INHA-NARAE/STM32-FC/(threads)

Thread 2 (2025-06-19):

LPS22HH 동작 안함.

leecurrent04, 2025-06-19:
[[Taiga] LPS22HH 기압계 동작 안함](https://taiga.naraeinha.cc/project/hanggongjeonja/issue/134)

LPS22HH 기압계 Software 리셋 안됨.
---------------------------

SW 리셋이 동작하지 않아, 센서 값도 0으로 출력되는 듯.

[코드](https://github.com/INHA-NARAE/STM32-FC/blob/main/SW/Plane/Core/Src/FC_AHRS/FC_Baro/LPS22HH/LPS22HH.c#L45)

```c
// STM32-FC/SW/Plane/Core/Src/FC_AHRS/FC_Baro/LPS22HH/LPS22HH.c

// Software Reset LPS22HH
temp_reg = LPS22HH_Readbyte(CTRL_REG2);
temp_reg = temp_reg | 0x04;
LPS22HH_Writebyte(CTRL_REG2, temp_reg);
while((LPS22HH_Readbyte(CTRL_REG2)&0x04)!=0x00){
}
```

데이터시트에 따르면,  SW 리셋 비트를 1로 설정하면 리셋 동작이 수행되고 비트가 0으로 되어야 한다.
그러나 비트가 0으로 안 변함.

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

### 로직 분석

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

첫번째 초록색 : 0x91 CTRL\_REG2 값 요청, 0x10 응답
첫번째 파란색 : 0x11 0x14 CTRL\_REG2에 0x14 쓰기 (SW 리셋 명령)
두번째 초록색 : 0x91 CTRL\_REG2 값 요청, 0x14 응답 (SW 리셋 중)
이하 반복

### 예상 원인

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

전원부 커패시터 이상으로 추정.
VDD 및 VDDIO에 각각 100nF 커패시터 연결 권장.
VDD에 4.7uF 커패시터 추가 권장.
그러나 실제 구현된 회로에서는 4.7uF만 연결됨.

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

커패시터 교체 후 동일 증상 시, 전류 부족일 수도 있음.
AHRS 용 별도 3.3V 레귤레이터 도입

Thread 4 (2025-06-23):

BMI323 에러

leecurrent04, 2025-06-23:
# 증상

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

BMI323 센서 값이 -1.0, 1.0으로 출력 됨.

초기 연결 이후, 일정 시간 경과시 문제 발생하는 것으로 추정됨.

# 특이점

로직 아날라이저 연결 후 부팅시, **증상 재현 안됨**.
증상 발현 후 로직 아날라이저 연결 시 MOSI 신호 에러

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

leecurrent04, 2025-07-25:
같은 SPI3 라인에 있는 LIS2MDF 센서의 기본 동작이 3-wire SPI 그랬던 것으로 추정됨.
해당 센서의 동작 모드를 4-wire SPI 설정하니 문제가 발생하지 않음.

Closed 2025-07-25.

Thread 19 (2025-09-05):

bug: roll, pitch에 따른 yaw 변동

sungho2574, 2025-09-05:
yaw는 그대로 둔 상테에서 roll, pitch에만 변화를 줘도 yaw가 같이 변합니다.
yaw축 pid 튜닝을 하기 전에 이 부분이 먼저 해결되어야 할 것 같습니다.

- 아래는 pitch에만 변화를 줄 때의 그래프입니다.
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

- 아래는 roll에만 변화를 줄 때의 그래프입니다.
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

그래프 캡쳐를 좀 잘못했는데 빨간색이 roll, 초록색이 pitch, 파란색이 yaw입니다.

leecurrent04, 2025-09-09:
지금 YAW 계산을 지자계와 roll+pitch로 계산하고 있는데,
지자계 값도 보정이 잘 안되어 있어요.

https://discord.com/channels/1289170468883927081/1289172196484186133/1413210099148914728
