INHA-NARAE/STM32-FC/HW/STM32-FC/STM32-FC.kicad_pcb

## KiCad design HW/STM32-FC/STM32-FC.kicad_pcb (2025-06-19)

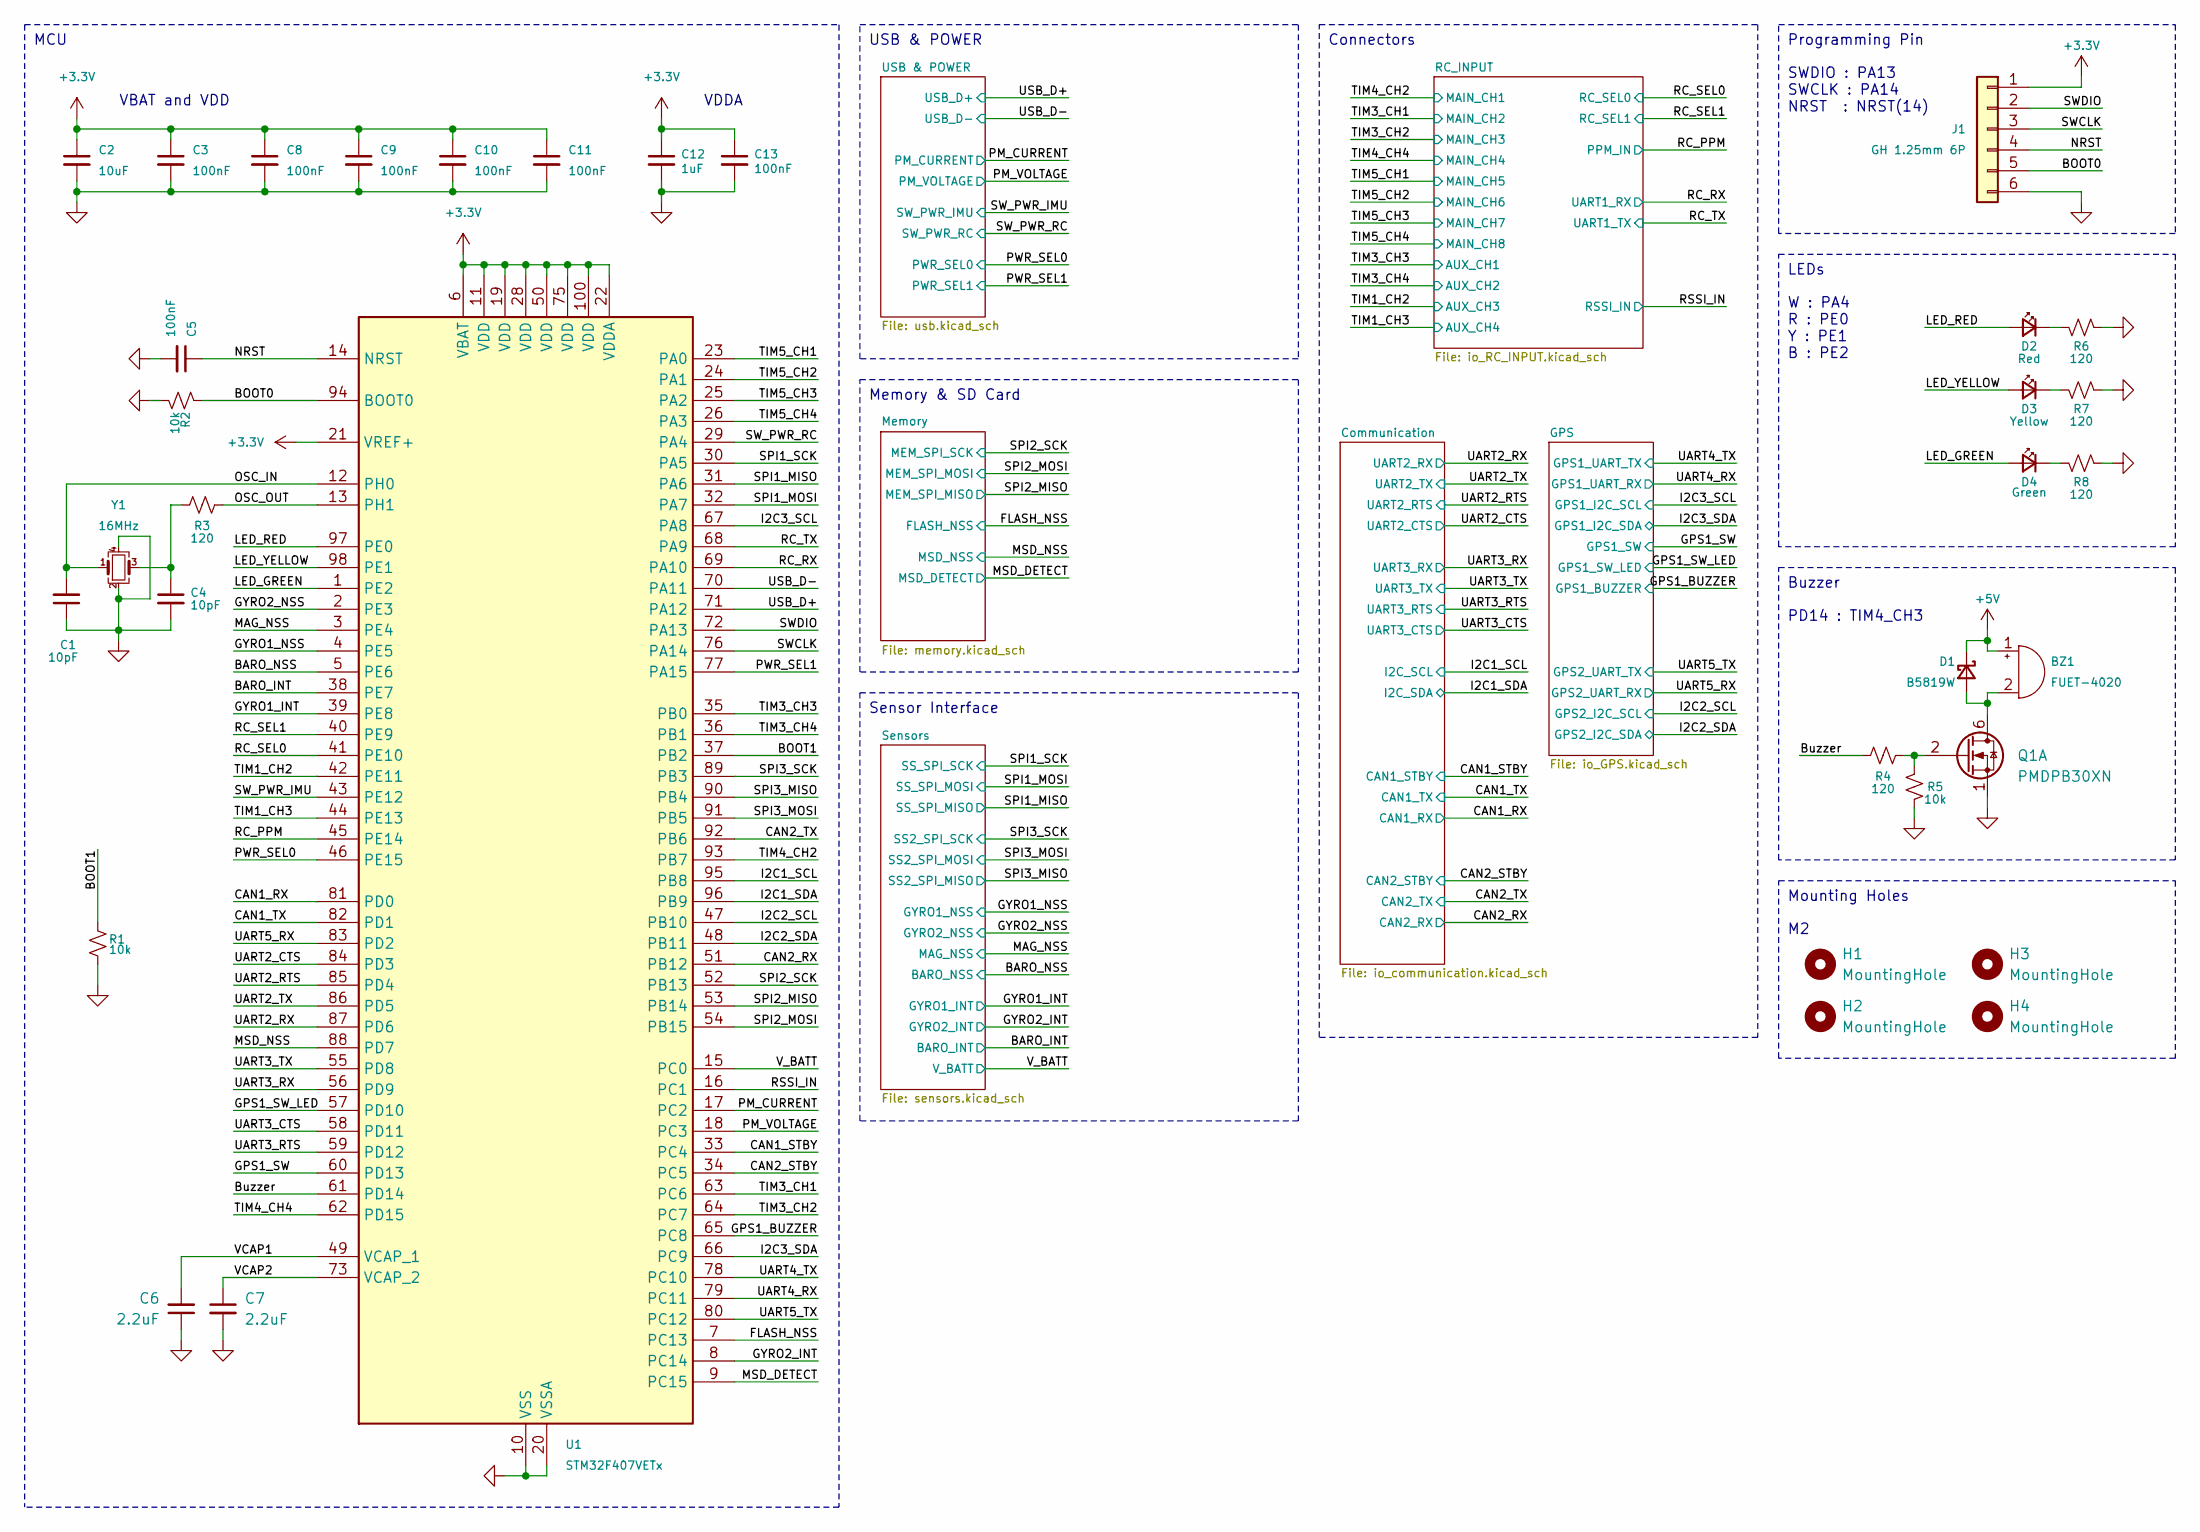
[picture p1: schematic STM32-FC.kicad_sch, STM32 Flight Controller]

Parts:
BZ1: FUET-4020; LCSC C391027
C1, C4: 10pF; C_0402_1005Metric; LCSC C1545
C2: 10uF; C_0402_1005Metric; LCSC C307415
C3, C5, C8, C9, C10, C11, C13: 100nF; C_0402_1005Metric; LCSC C1525
C6, C7: 2.2uF; C_0402_1005Metric; LCSC C170151
C12: 1uF; C_0402_1005Metric; LCSC C14445
D1: B5819W; D_SOD-323; LCSC C22624
D2: Red; LED_0402_1005Metric; LCSC C130719
D3: Yellow; LED_0402_1005Metric; LCSC C130721
D4: Green; LED_0402_1005Metric; LCSC C130722
H1, H2, H3, H4: MountingHole; MountingHole_2.2mm_M2
J1: GH 1.25mm 6P; JST_GH_SM06B-GHS-TB_06x1.25mm_Angled; LCSC C133065
Q1: PMDPB30XN; Nexperia_SOT1118; LCSC C478009
R1, R2, R5: 10k; R_0402_1005Metric; LCSC C25531
R3, R4, R6, R7, R8: 120; R_0402_1005Metric; LCSC C25079
U1: STM32F407VETx; LQFP-100_14x14mm_P0.5mm; LCSC C28730
Y1: 16MHz; Crystal_SMD_Abracon_ABM8G-4Pin_3.2x2.5mm; LCSC C1985423

Connections:
+3.3V: C2.1, C3.1, C8.1, C9.1, C10.1, C11.1, C12.1, C13.1, J1.1, U1.6 (VBAT), U1.11 (VDD), U1.19 (VDD), U1.21 (VREF+), U1.22 (VDDA), U1.28 (VDD), U1.50 (VDD), U1.75 (VDD), U1.100 (VDD); also elsewhere on the board
+5V: BZ1.1 (-), D1.1 (K); also elsewhere on the board
/BARO_INT: U1.38 (PE7); also elsewhere on the board
/BARO_NSS: U1.5 (PE6); also elsewhere on the board
/BOOT0: J1.5, R2.1, U1.94 (BOOT0)
/BOOT1: R1.1, U1.37 (PB2)
/Buzzer: R4.1, U1.61 (PD14)
/CAN1_RX: U1.81 (PD0); also elsewhere on the board
/CAN1_STBY: U1.33 (PC4); also elsewhere on the board
/CAN1_TX: U1.82 (PD1); also elsewhere on the board
/CAN2_RX: U1.51 (PB12); also elsewhere on the board
/CAN2_STBY: U1.34 (PC5); also elsewhere on the board
/CAN2_TX: U1.92 (PB6); also elsewhere on the board
/FLASH_NSS: U1.7 (PC13); also elsewhere on the board
/GPS1_BUZZER: U1.65 (PC8); also elsewhere on the board
/GPS1_SW: U1.60 (PD13); also elsewhere on the board
/GPS1_SW_LED: U1.57 (PD10); also elsewhere on the board
/GYRO1_INT: U1.39 (PE8); also elsewhere on the board
/GYRO1_NSS: U1.4 (PE5); also elsewhere on the board
/GYRO2_INT: U1.8 (PC14); also elsewhere on the board
/GYRO2_NSS: U1.2 (PE3); also elsewhere on the board
/I2C1_SCL: U1.95 (PB8); also elsewhere on the board
/I2C1_SDA: U1.96 (PB9); also elsewhere on the board
/I2C2_SCL: U1.47 (PB10); also elsewhere on the board
/I2C2_SDA: U1.48 (PB11); also elsewhere on the board
/I2C3_SCL: U1.67 (PA8); also elsewhere on the board
/I2C3_SDA: U1.66 (PC9); also elsewhere on the board
/LED_GREEN: D4.2 (A), U1.1 (PE2)
/LED_RED: D2.2 (A), U1.97 (PE0)
/LED_YELLOW: D3.2 (A), U1.98 (PE1)
/MAG_NSS: U1.3 (PE4); also elsewhere on the board
/MSD_DETECT: U1.9 (PC15); also elsewhere on the board
/MSD_NSS: U1.88 (PD7); also elsewhere on the board
/NRST: C5.1, J1.4, U1.14 (NRST)
/OSC_IN: C1.2, U1.12 (PH0), Y1.1
/OSC_OUT: R3.2, U1.13 (PH1)
/PM_CURRENT: U1.17 (PC2); also elsewhere on the board
/PM_VOLTAGE: U1.18 (PC3); also elsewhere on the board
/PWR_SEL0: U1.46 (PE15); also elsewhere on the board
/PWR_SEL1: U1.77 (PA15); also elsewhere on the board
/RC_PPM: U1.45 (PE14); also elsewhere on the board
/RC_RX: U1.69 (PA10); also elsewhere on the board
/RC_SEL0: U1.41 (PE10); also elsewhere on the board
/RC_SEL1: U1.40 (PE9); also elsewhere on the board
/RC_TX: U1.68 (PA9); also elsewhere on the board
/RSSI_IN: U1.16 (PC1); also elsewhere on the board
/SPI1_MISO: U1.31 (PA6); also elsewhere on the board
/SPI1_MOSI: U1.32 (PA7); also elsewhere on the board
/SPI1_SCK: U1.30 (PA5); also elsewhere on the board
/SPI2_MISO: U1.53 (PB14); also elsewhere on the board
/SPI2_MOSI: U1.54 (PB15); also elsewhere on the board
/SPI2_SCK: U1.52 (PB13); also elsewhere on the board
/SPI3_MISO: U1.90 (PB4); also elsewhere on the board
/SPI3_MOSI: U1.91 (PB5); also elsewhere on the board
/SPI3_SCK: U1.89 (PB3); also elsewhere on the board
/SWCLK: J1.3, U1.76 (PA14)
/SWDIO: J1.2, U1.72 (PA13)
/SW_PWR_IMU: U1.43 (PE12); also elsewhere on the board
/SW_PWR_RC: U1.29 (PA4); also elsewhere on the board
/TIM1_CH2: U1.42 (PE11); also elsewhere on the board
/TIM1_CH3: U1.44 (PE13); also elsewhere on the board
/TIM3_CH1: U1.63 (PC6); also elsewhere on the board
/TIM3_CH2: U1.64 (PC7); also elsewhere on the board
/TIM3_CH3: U1.35 (PB0); also elsewhere on the board
/TIM3_CH4: U1.36 (PB1); also elsewhere on the board
/TIM4_CH2: U1.93 (PB7); also elsewhere on the board
/TIM4_CH4: U1.62 (PD15); also elsewhere on the board
/TIM5_CH1: U1.23 (PA0); also elsewhere on the board
/TIM5_CH2: U1.24 (PA1); also elsewhere on the board
/TIM5_CH3: U1.25 (PA2); also elsewhere on the board
/TIM5_CH4: U1.26 (PA3); also elsewhere on the board
/UART2_CTS: U1.84 (PD3); also elsewhere on the board
/UART2_RTS: U1.85 (PD4); also elsewhere on the board
/UART2_RX: U1.87 (PD6); also elsewhere on the board
/UART2_TX: U1.86 (PD5); also elsewhere on the board
/UART3_CTS: U1.58 (PD11); also elsewhere on the board
/UART3_RTS: U1.59 (PD12); also elsewhere on the board
/UART3_RX: U1.56 (PD9); also elsewhere on the board
/UART3_TX: U1.55 (PD8); also elsewhere on the board
/UART4_RX: U1.79 (PC11); also elsewhere on the board
/UART4_TX: U1.78 (PC10); also elsewhere on the board
/UART5_RX: U1.83 (PD2); also elsewhere on the board
/UART5_TX: U1.80 (PC12); also elsewhere on the board
/USB_D+: U1.71 (PA12); also elsewhere on the board
/USB_D-: U1.70 (PA11); also elsewhere on the board
/VCAP1: C6.2, U1.49 (VCAP_1)
/VCAP2: C7.1, U1.73 (VCAP_2)
/V_BATT: U1.15 (PC0); also elsewhere on the board
unnamed: BZ1.2 (+), D1.2 (A), Q1.6 (D), Q1.7 (D)
unnamed: C4.1, R3.1, Y1.3
unnamed: D2.1 (K), R6.1
unnamed: D3.1 (K), R7.1
unnamed: D4.1 (K), R8.1
unnamed: Q1.2 (G), R4.2, R5.1

Notes on the sheet:
Connectors
PD14 : TIM4_CH3
MCU
VDDA
Buzzer
Sensor Interface
LEDs
Programming Pin
Memory & SD Card
USB & POWER
W : PA4 R : PE0 Y : PE1 B : PE2
SWDIO : PA13 SWCLK : PA14 NRST : NRST(14)
VBAT and VDD
Mounting Holes

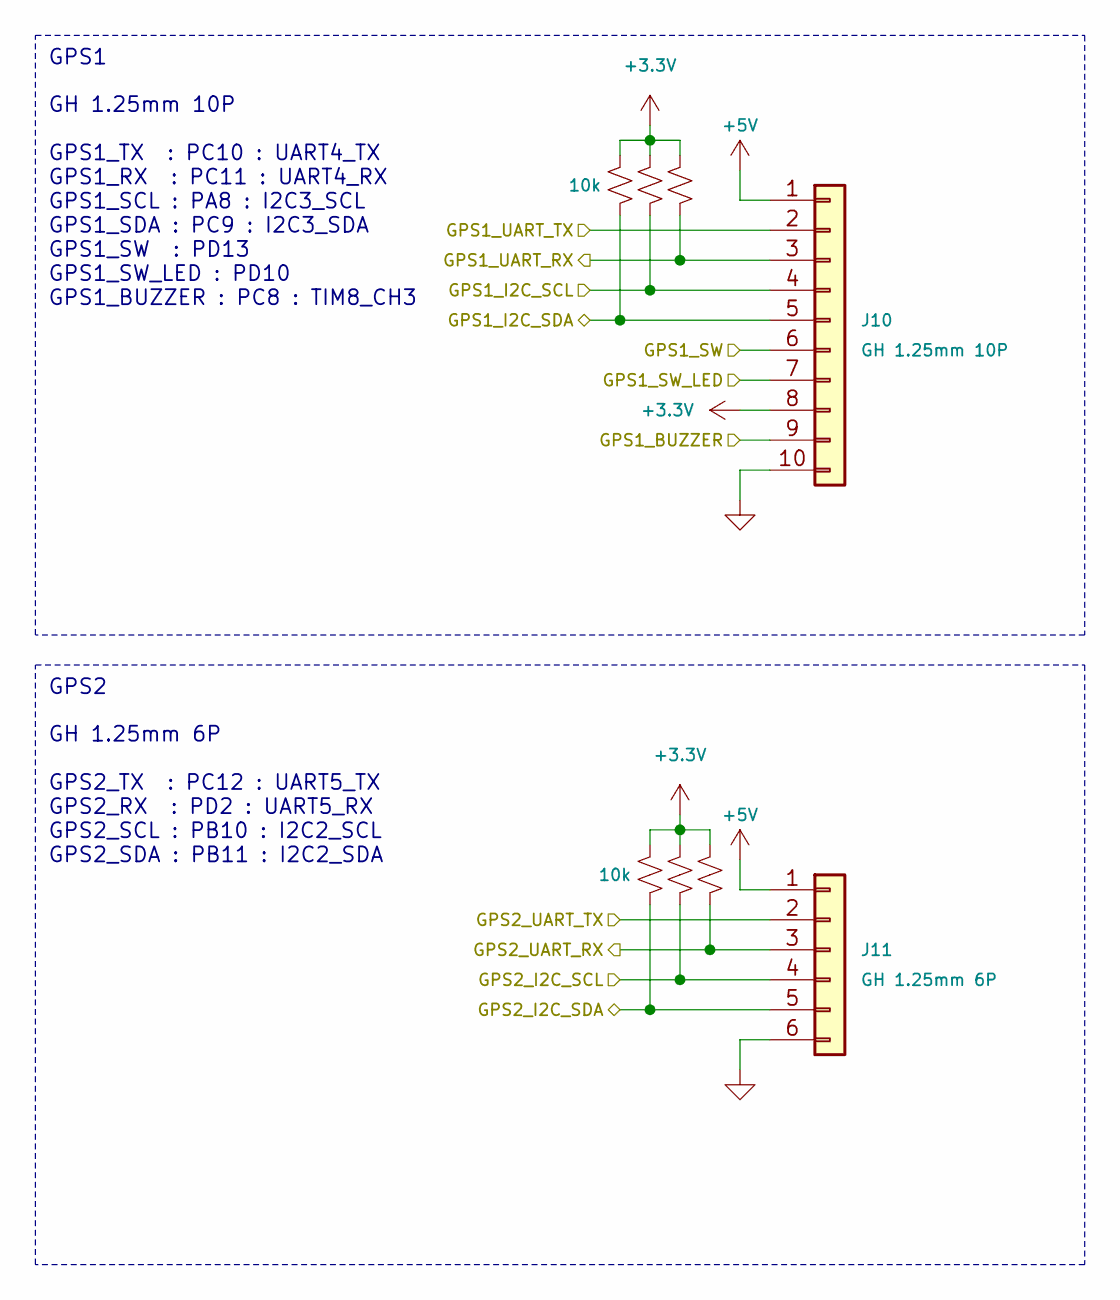
[picture p2: schematic io_GPS.kicad_sch, GPS]

Parts:
J10: GH 1.25mm 10P; JST_GH_SM10B-GHS-TB_10x1.25mm_Angled; LCSC C2683602
J11: GH 1.25mm 6P; JST_GH_SM06B-GHS-TB_06x1.25mm_Angled; LCSC C133065
R38, R39, R40, R41, R42, R43: 10k; R_0402_1005Metric; LCSC C25531

Connections:
+3.3V: J10.8, R38.1, R39.1, R40.1, R41.1, R42.1, R43.1; also elsewhere on the board
+5V: J10.1, J11.1; also elsewhere on the board
/GPS1_BUZZER: J10.9; also elsewhere on the board
/GPS1_SW: J10.6; also elsewhere on the board
/GPS1_SW_LED: J10.7; also elsewhere on the board
/I2C2_SCL: J11.4, R42.2; also elsewhere on the board
/I2C2_SDA: J11.5, R40.2; also elsewhere on the board
/I2C3_SCL: J10.4, R39.2; also elsewhere on the board
/I2C3_SDA: J10.5, R38.2; also elsewhere on the board
/UART4_RX: J10.3, R41.2; also elsewhere on the board
/UART4_TX: J10.2; also elsewhere on the board
/UART5_RX: J11.3, R43.2; also elsewhere on the board
/UART5_TX: J11.2; also elsewhere on the board

Notes on the sheet:
GH 1.25mm 10P GPS1_TX : PC10 : UART4_TX GPS1_RX : PC11 : UART4_RX GPS1_SCL : PA8 : I2C3_SCL GPS1_SDA : PC9 : I2C3_SDA GPS1_SW : PD13 GPS1_SW_LED : PD10 GPS1_BUZZER : PC8 : TIM8_CH3
GH 1.25mm 6P GPS2_TX : PC12 : UART5_TX GPS2_RX : PD2 : UART5_RX GPS2_SCL : PB10 : I2C2_SCL GPS2_SDA : PB11 : I2C2_SDA
GPS2
GPS1

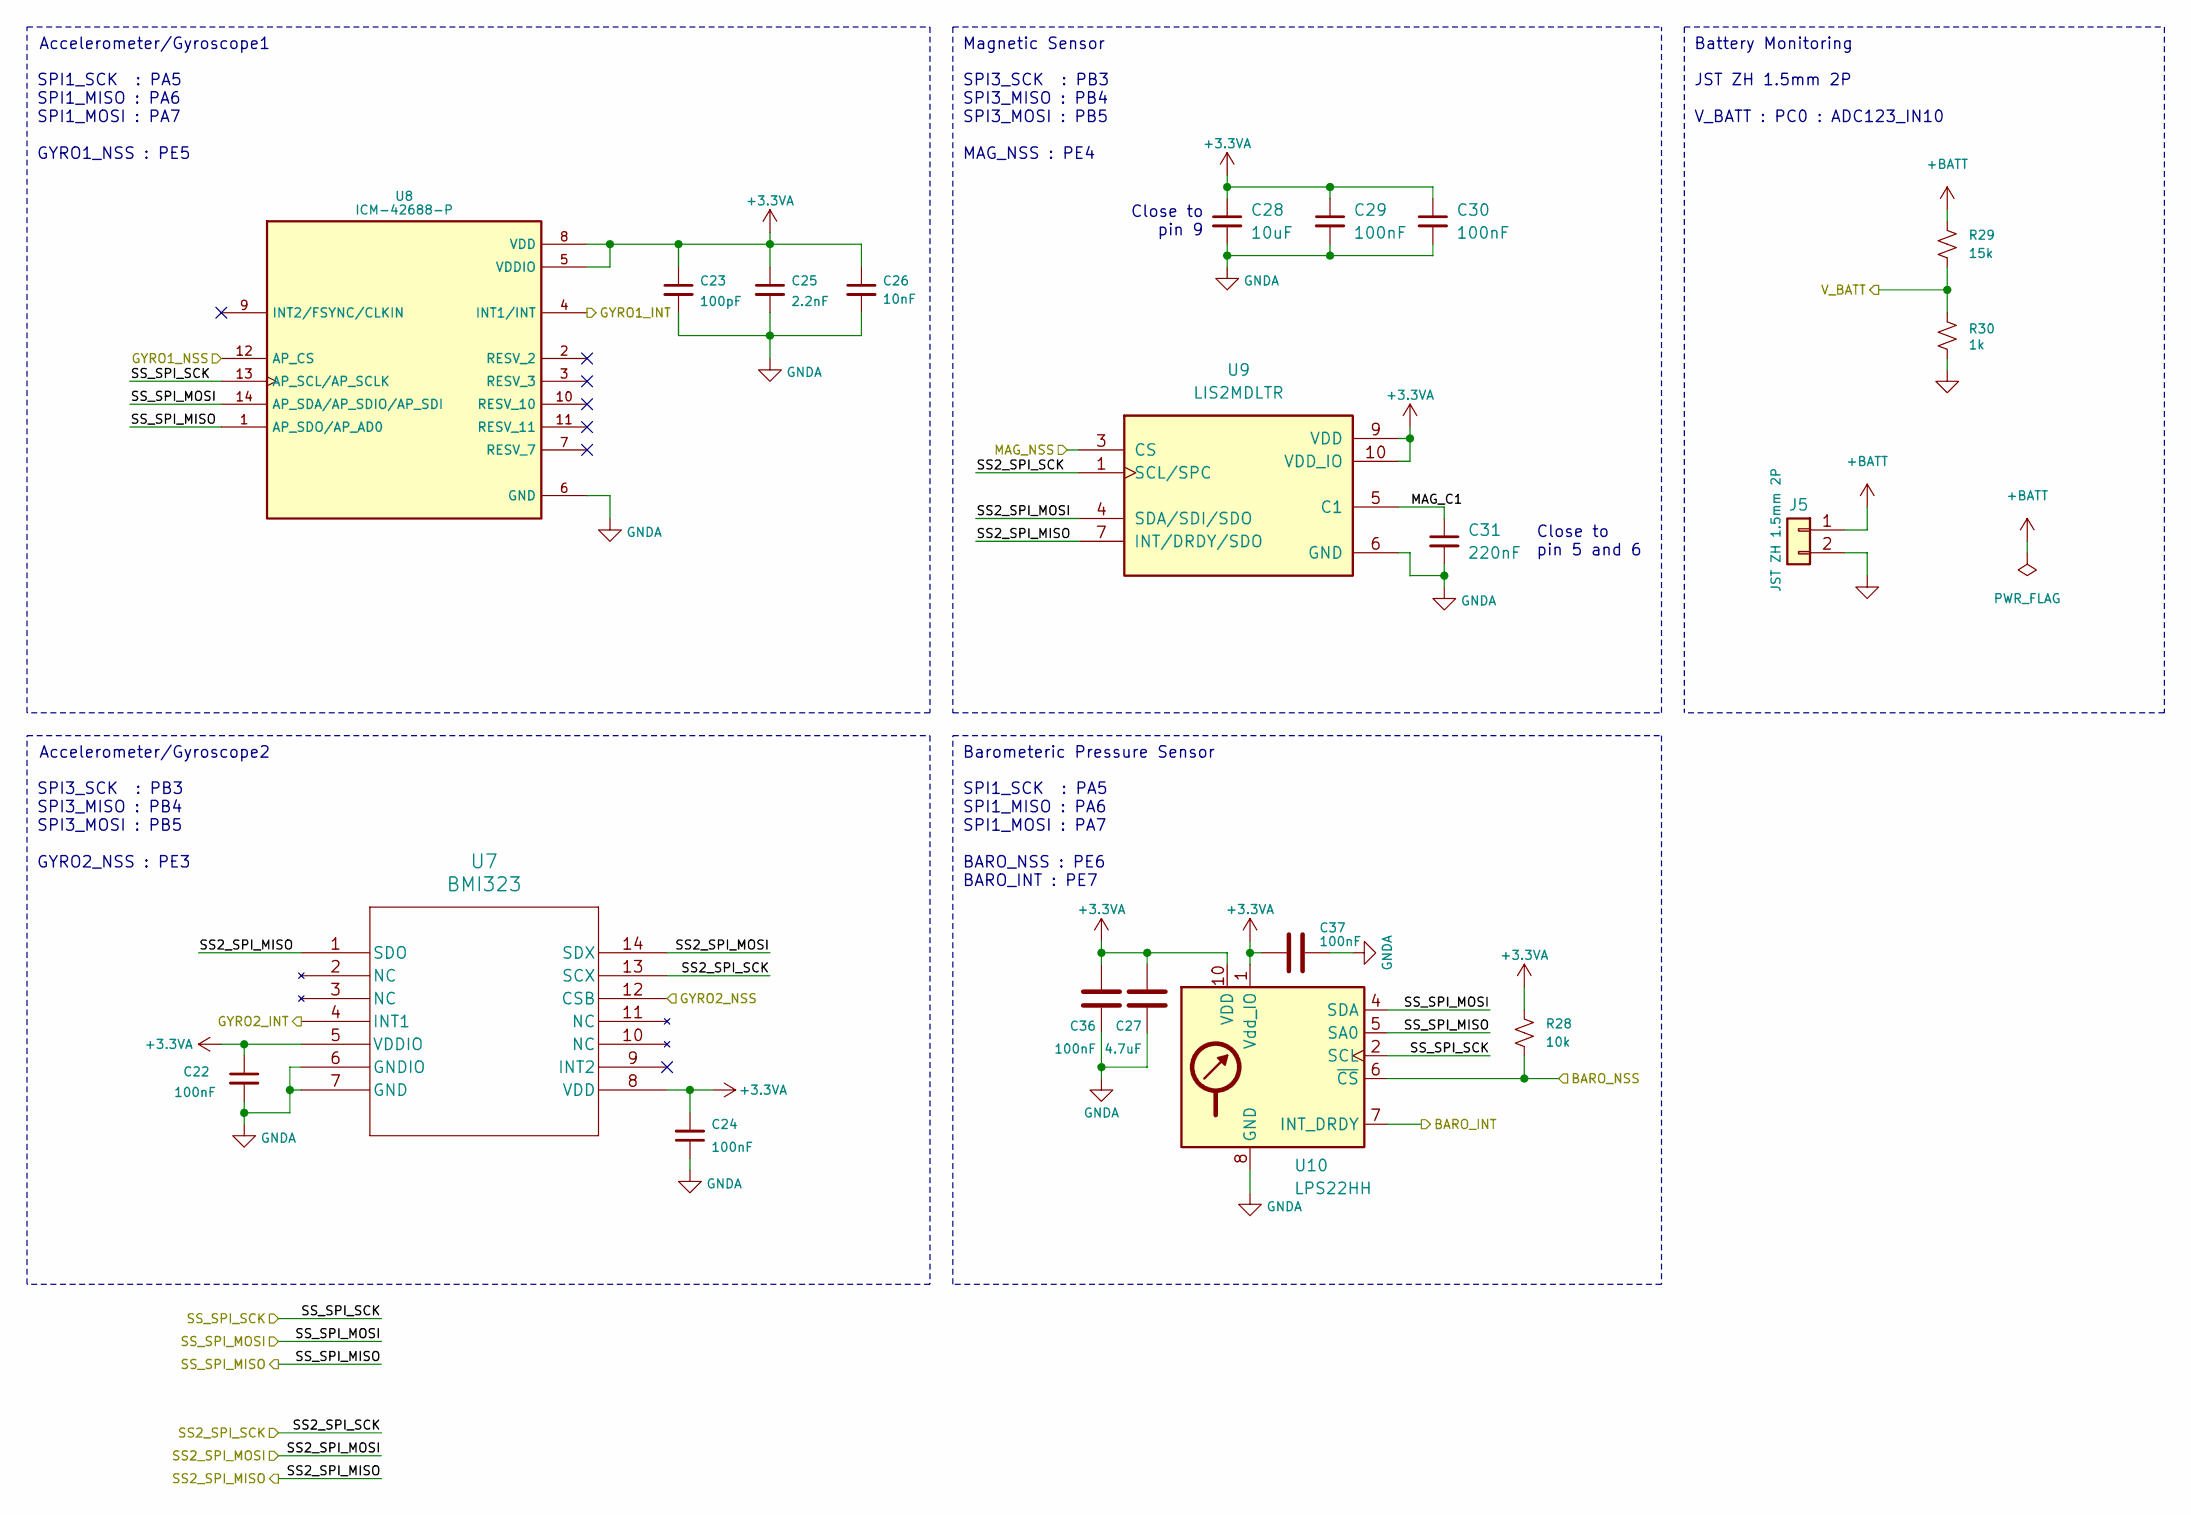
[picture p3: schematic sensors.kicad_sch]

Parts:
C22, C24, C29, C30: 100nF; C_0402_1005Metric; LCSC C1525
C23: 100pF; C_0402_1005Metric; LCSC C152819
C25: 2.2nF; C_0402_1005Metric; LCSC C84703
C26: 10nF; C_0402_1005Metric; LCSC C15195
C27: 4.7uF; C_0402_1005Metric; LCSC C307423
C28: 10uF; C_0402_1005Metric; LCSC C307415
C31: 220nF; C_0402_1005Metric; LCSC C16651
C36, C37: 100nF; C_0402_1005Metric; LCSC C307423
J5: JST ZH 1.5mm 2P; JST_ZH_S2B-ZR-SM4A-TF_1x02-1MP_P1.50mm_Horizontal; LCSC C265329
R28: 10k; R_0402_1005Metric; LCSC C25531
R29: 15k; R_0402_1005Metric; LCSC C25539
R30: 1k; R_0402_1005Metric; LCSC C106235
U7: BMI323; BMI323_L; LCSC C5368700
U8: ICM-42688-P; IIM42352_L; LCSC C1850418
U9: LIS2MDLTR; PARTREV Rev 5; LCSC C919695
U10: LPS22HH; ST_HLGA-10_2x2mm_P0.5mm_LayoutBorder3x2y; LCSC C2827824

Connections:
+3.3VA: C22.1, C23.1, C24.2, C25.1, C26.1, C27.2, C28.1, C29.1, C30.1, C36.2, C37.2, R28.1, U7.5 (VDDIO), U7.8 (VDD), U8.5 (VDDIO), U8.8 (VDD), U9.9 (VDD), U9.10 (VDD_IO), U10.1 (Vdd_IO), U10.10 (VDD); also elsewhere on the board
+BATT: J5.1, R29.1
/BARO_INT: U10.7 (INT_DRDY); also elsewhere on the board
/BARO_NSS: R28.2, U10.6 (~CS); also elsewhere on the board
/GYRO1_INT: U8.4 (INT1/INT); also elsewhere on the board
/GYRO1_NSS: U8.12 (AP_CS); also elsewhere on the board
/GYRO2_INT: U7.4 (INT1); also elsewhere on the board
/GYRO2_NSS: U7.12 (CSB); also elsewhere on the board
/MAG_NSS: U9.3 (CS); also elsewhere on the board
/SPI1_MISO: U8.1 (AP_SDO/AP_AD0), U10.5 (SA0); also elsewhere on the board
/SPI1_MOSI: U8.14 (AP_SDA/AP_SDIO/AP_SDI), U10.4 (SDA); also elsewhere on the board
/SPI1_SCK: U8.13 (AP_SCL/AP_SCLK), U10.2 (SCL); also elsewhere on the board
/SPI3_MISO: U7.1 (SDO), U9.7 (INT/DRDY/SDO); also elsewhere on the board
/SPI3_MOSI: U7.14 (SDX), U9.4 (SDA/SDI/SDO); also elsewhere on the board
/SPI3_SCK: U7.13 (SCX), U9.1 (SCL/SPC); also elsewhere on the board
/Sensors/MAG_C1: C31.1, U9.5 (C1)
/V_BATT: R29.2, R30.1; also elsewhere on the board

Notes on the sheet:
Close to pin 9
Magnetic Sensor
Barometeric Pressure Sensor
Battery Monitoring
Accelerometer/Gyroscope1
SPI3_SCK : PB3 SPI3_MISO : PB4 SPI3_MOSI : PB5 GYRO2_NSS : PE3
SPI1_SCK : PA5 SPI1_MISO : PA6 SPI1_MOSI : PA7 BARO_NSS : PE6 BARO_INT : PE7
JST ZH 1.5mm 2P V_BATT : PC0 : ADC123_IN10
SPI1_SCK : PA5 SPI1_MISO : PA6 SPI1_MOSI : PA7 GYRO1_NSS : PE5
Accelerometer/Gyroscope2
Close to pin 5 and 6
SPI3_SCK : PB3 SPI3_MISO : PB4 SPI3_MOSI : PB5 MAG_NSS : PE4

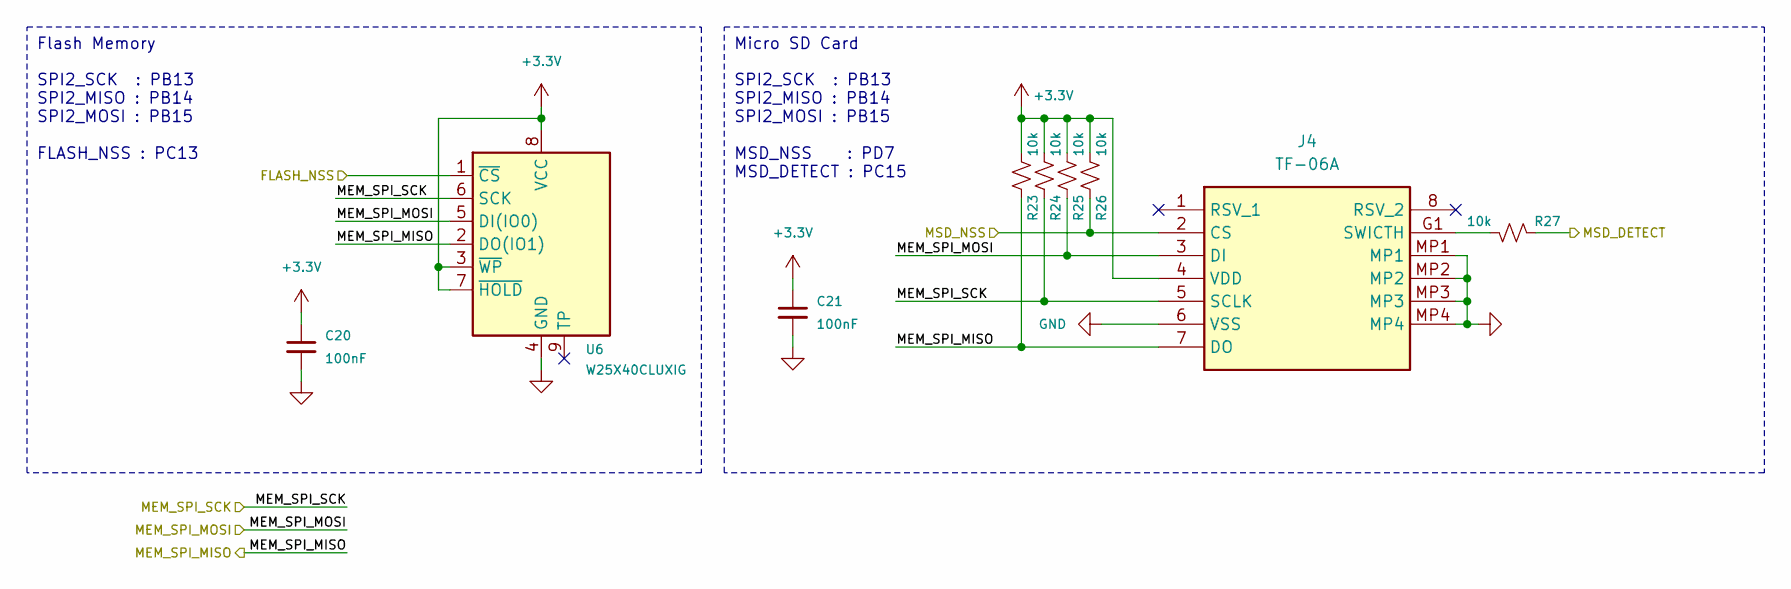
[picture p4: schematic memory.kicad_sch]

Parts:
C20, C21: 100nF; C_0402_1005Metric; LCSC C1525
J4: TF-06A; TF06A; Manufacturer_Part_Number TF-06A; LCSC C693844
R23, R24, R25, R26, R27: 10k; R_0402_1005Metric; LCSC C25531
U6: W25X40CLUXIG; USON_LUXIG TR_WIN-L; LCSC C401661

Connections:
+3.3V: C20.1, C21.1, J4.4 (VDD), R23.1, R24.1, R25.1, R26.1, U6.3 (~WP), U6.7 (~HOLD), U6.8 (VCC); also elsewhere on the board
/FLASH_NSS: U6.1 (~CS); also elsewhere on the board
/MSD_DETECT: R27.1; also elsewhere on the board
/MSD_NSS: J4.2 (CS), R26.2; also elsewhere on the board
/SPI2_MISO: J4.7 (DO), R23.2, U6.2 (DO(IO1)); also elsewhere on the board
/SPI2_MOSI: J4.3 (DI), R25.2, U6.5 (DI(IO0)); also elsewhere on the board
/SPI2_SCK: J4.5 (SCLK), R24.2, U6.6 (SCK); also elsewhere on the board
unnamed: J4.G1 (SWICTH), R27.2

Notes on the sheet:
Micro SD Card
SPI2_SCK : PB13 SPI2_MISO : PB14 SPI2_MOSI : PB15 FLASH_NSS : PC13
Flash Memory
SPI2_SCK : PB13 SPI2_MISO : PB14 SPI2_MOSI : PB15 MSD_NSS : PD7 MSD_DETECT : PC15

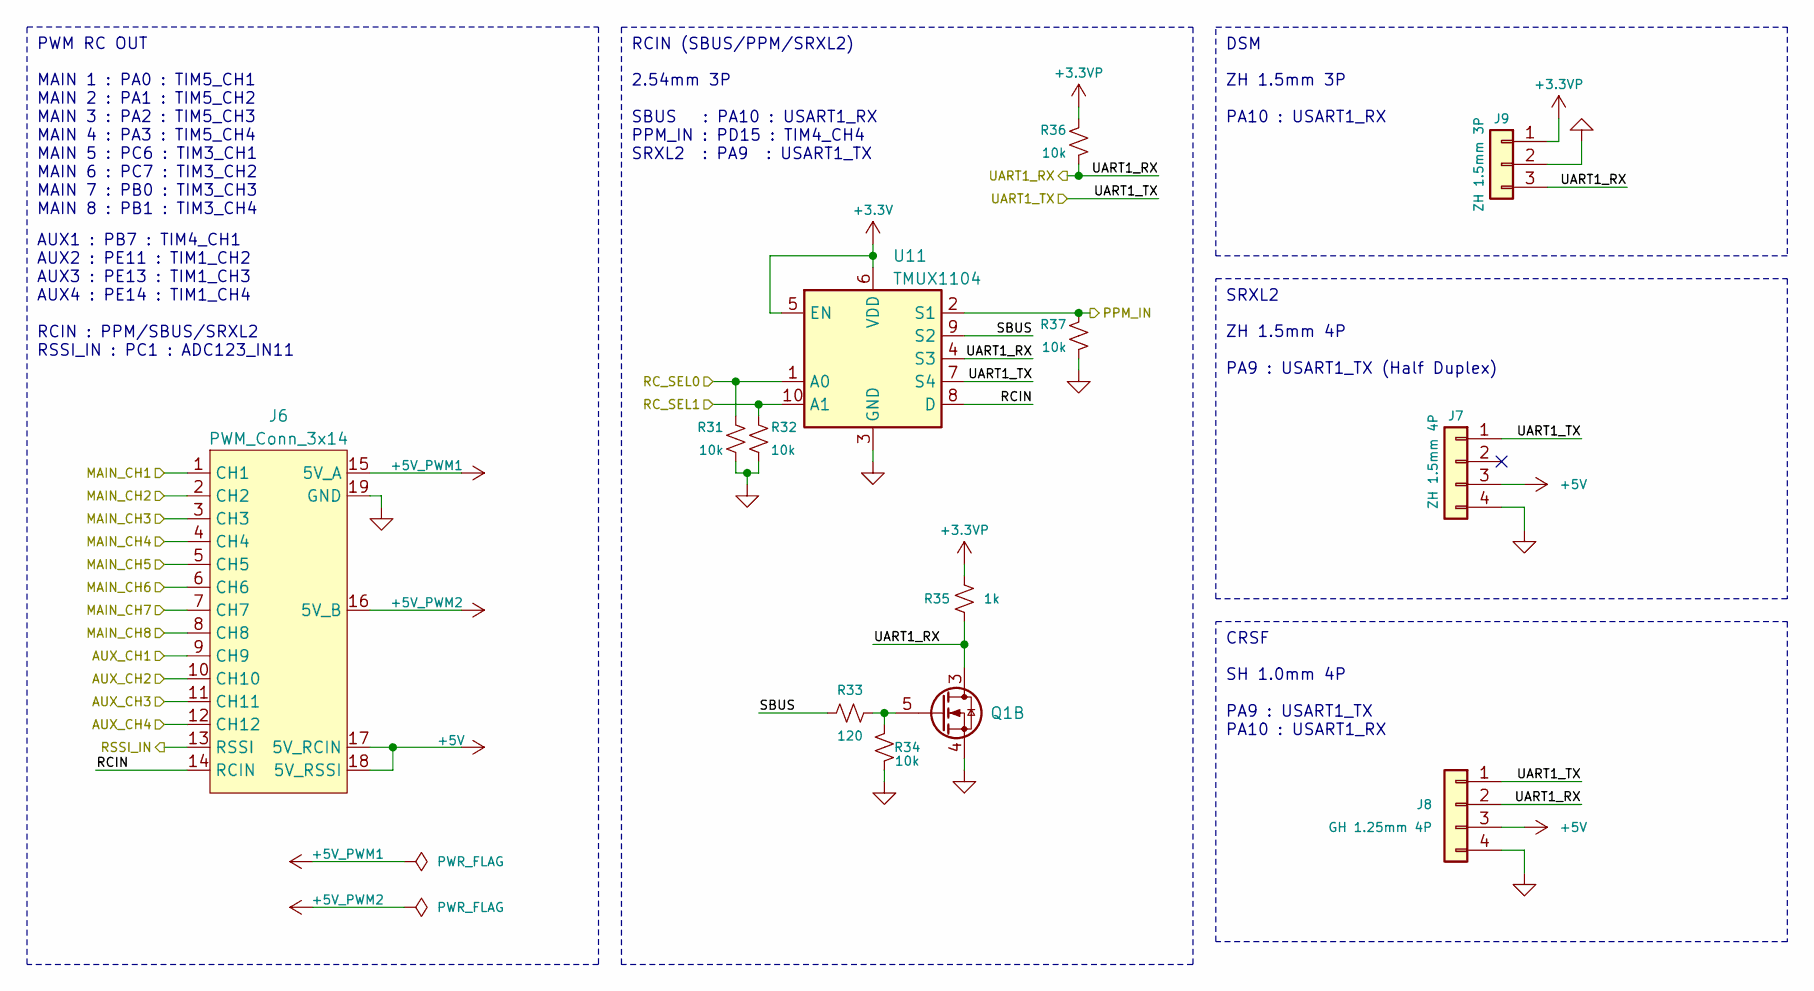
[picture p5: schematic io_RC_INPUT.kicad_sch, RC_INPUT]

Parts:
J6: PWM_Conn_3x14; LCSC C3327492
J7: ZH 1.5mm 4P; JST_ZH_S4B-ZR-SM4A-TF_1x04-1MP_P1.50mm_Horizontal; LCSC C485354
J8: GH 1.25mm 4P; JST_GH_SM04B-GHS-TB_04x1.25mm_Angled; LCSC C189895
J9: ZH 1.5mm 3P; JST_ZH_S3B-ZR-SM4A-TF_1x03-1MP_P1.50mm_Horizontal; LCSC C72591
Q1: PMDPB30XN; Nexperia_SOT1118; LCSC C478009
R31, R32, R34, R36, R37: 10k; R_0402_1005Metric; LCSC C25531
R33: 120; R_0402_1005Metric; LCSC C25079
R35: 1k; R_0402_1005Metric; LCSC C106235
U11: TMUX1104; LCSC C2865387

Connections:
+3.3V: U11.5 (EN), U11.6 (VDD); also elsewhere on the board
+3.3VP: J9.1, R35.1, R36.1; also elsewhere on the board
+5V: J6.17 (5V_RCIN), J6.18 (5V_RSSI), J7.3, J8.3; also elsewhere on the board
+5V_PWM1: J6.15 (5V_A); also elsewhere on the board
+5V_PWM2: J6.16 (5V_B); also elsewhere on the board
/RC_INPUT/RCIN: J6.14 (RCIN), U11.8 (D)
/RC_INPUT/SBUS: R33.1, U11.9 (S2)
/RC_PPM: R37.1, U11.2 (S1); also elsewhere on the board
/RC_RX: J8.2, J9.3, Q1.3 (D), Q1.8 (D), R35.2, R36.2, U11.4 (S3); also elsewhere on the board
/RC_SEL0: R31.1, U11.1 (A0); also elsewhere on the board
/RC_SEL1: R32.1, U11.10 (A1); also elsewhere on the board
/RC_TX: J7.1, J8.1, U11.7 (S4); also elsewhere on the board
/RSSI_IN: J6.13 (RSSI); also elsewhere on the board
/TIM1_CH2: J6.11 (CH11); also elsewhere on the board
/TIM1_CH3: J6.12 (CH12); also elsewhere on the board
/TIM3_CH1: J6.2 (CH2); also elsewhere on the board
/TIM3_CH2: J6.3 (CH3); also elsewhere on the board
/TIM3_CH3: J6.9 (CH9); also elsewhere on the board
/TIM3_CH4: J6.10 (CH10); also elsewhere on the board
/TIM4_CH2: J6.1 (CH1); also elsewhere on the board
/TIM4_CH4: J6.4 (CH4); also elsewhere on the board
/TIM5_CH1: J6.5 (CH5); also elsewhere on the board
/TIM5_CH2: J6.6 (CH6); also elsewhere on the board
/TIM5_CH3: J6.7 (CH7); also elsewhere on the board
/TIM5_CH4: J6.8 (CH8); also elsewhere on the board
unnamed: Q1.5 (G), R33.2, R34.1

Notes on the sheet:
CRSF
RCIN (SBUS/PPM/SRXL2)
ZH 1.5mm 3P PA10 : USART1_RX
SRXL2
2.54mm 3P SBUS : PA10 : USART1_RX PPM_IN : PD15 : TIM4_CH4 SRXL2 : PA9 : USART1_TX
SH 1.0mm 4P PA9 : USART1_TX PA10 : USART1_RX
DSM
MAIN 1 : PA0 : TIM5_CH1 MAIN 2 : PA1 : TIM5_CH2 MAIN 3 : PA2 : TIM5_CH3 MAIN 4 : PA3 : TIM5_CH4 MAIN 5 : PC6 : TIM3_CH1 MAIN 6 : PC7 : TIM3_CH2 MAIN 7 : PB0 : TIM3_CH3 MAIN 8 : PB1 : TIM3_CH4
PWM RC OUT
AUX1 : PB7 : TIM4_CH1 AUX2 : PE11 : TIM1_CH2 AUX3 : PE13 : TIM1_CH3 AUX4 : PE14 : TIM1_CH4 RCIN : PPM/SBUS/SRXL2 RSSI_IN : PC1 : ADC123_IN11
ZH 1.5mm 4P PA9 : USART1_TX (Half Duplex)

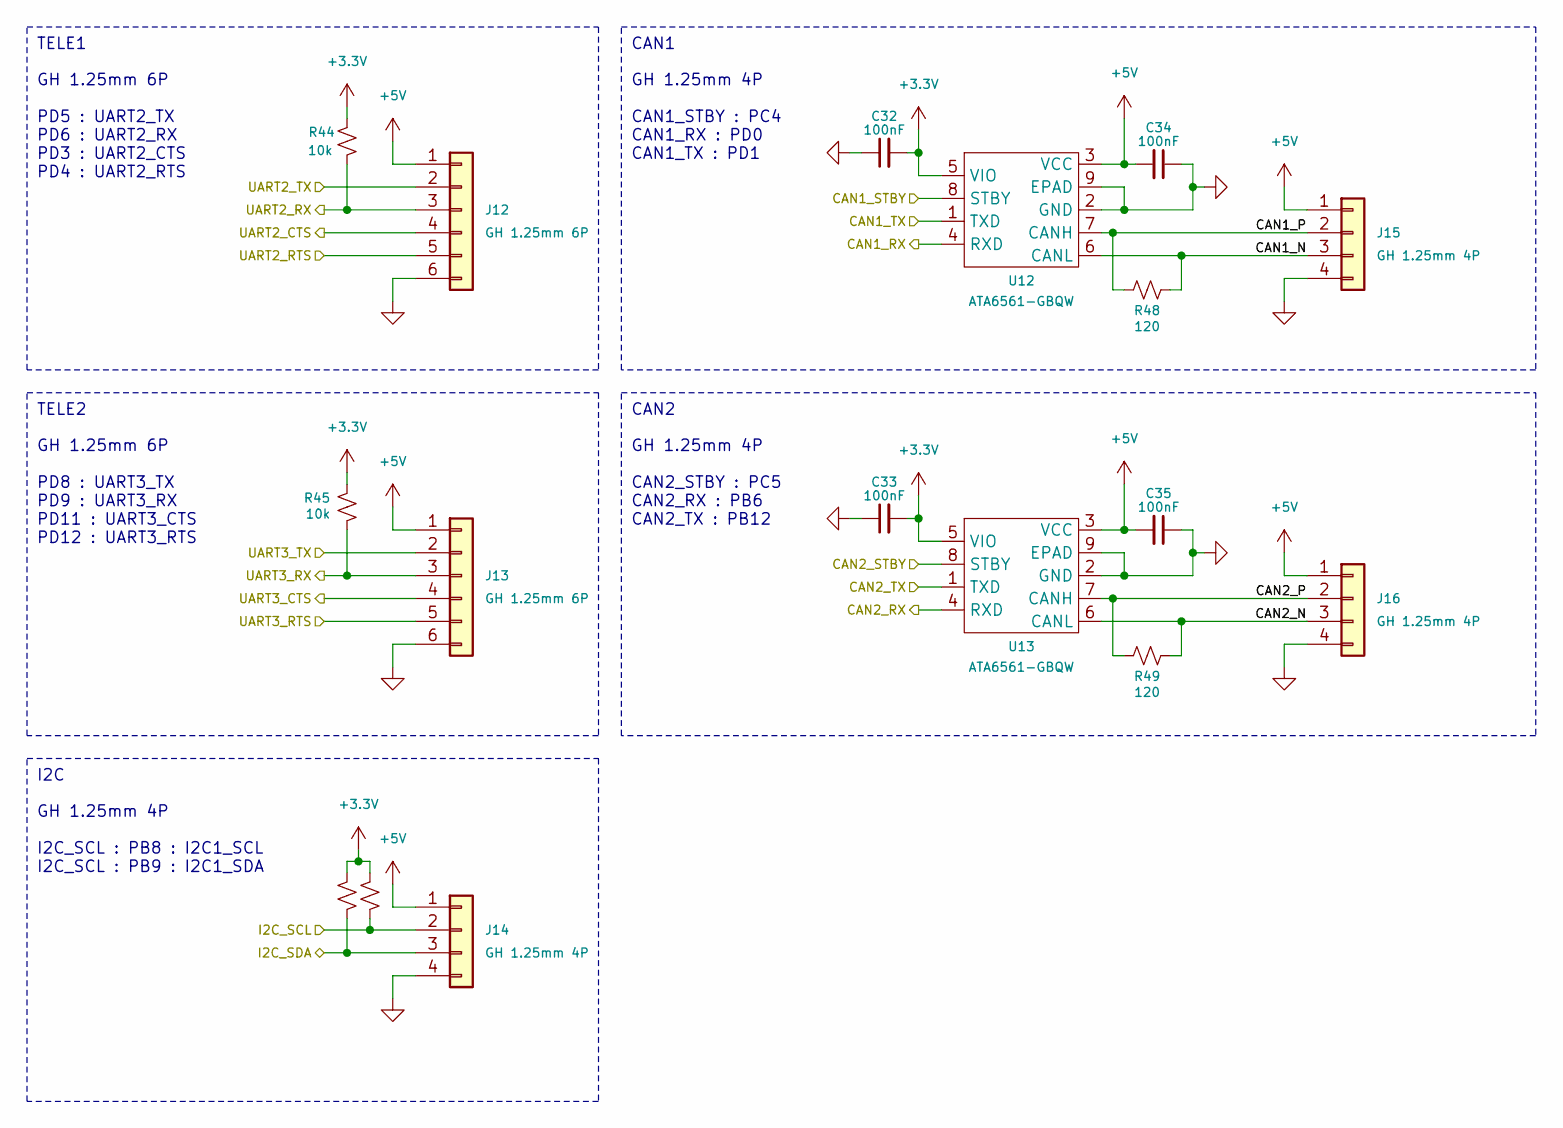
[picture p6: schematic io_communication.kicad_sch, Communication]

Parts:
C32, C33, C34, C35: 100nF; C_0402_1005Metric; LCSC C1525
J12, J13: GH 1.25mm 6P; JST_GH_SM06B-GHS-TB_06x1.25mm_Angled; LCSC C133065
J14, J15, J16: GH 1.25mm 4P; JST_GH_SM04B-GHS-TB_04x1.25mm_Angled; LCSC C189895
R44, R45, R46, R47: 10k; R_0402_1005Metric; LCSC C25531
R48, R49: 120; R_0402_1005Metric; LCSC C25079
U12, U13: ATA6561-GBQW; VDFN8_3X3_MCH-L; LCSC C617297

Connections:
+3.3V: C32.2, C33.2, R44.1, R45.1, R46.1, R47.1, U12.5 (VIO), U13.5 (VIO); also elsewhere on the board
+5V: C34.2, C35.2, J12.1, J13.1, J14.1, J15.1, J16.1, U12.3 (VCC), U13.3 (VCC); also elsewhere on the board
/CAN1_RX: U12.4 (RXD); also elsewhere on the board
/CAN1_STBY: U12.8 (STBY); also elsewhere on the board
/CAN1_TX: U12.1 (TXD); also elsewhere on the board
/CAN2_RX: U13.4 (RXD); also elsewhere on the board
/CAN2_STBY: U13.8 (STBY); also elsewhere on the board
/CAN2_TX: U13.1 (TXD); also elsewhere on the board
/Communication/CAN1_N: J15.3, R48.2, U12.6 (CANL)
/Communication/CAN1_P: J15.2, R48.1, U12.7 (CANH)
/Communication/CAN2_N: J16.3, R49.2, U13.6 (CANL)
/Communication/CAN2_P: J16.2, R49.1, U13.7 (CANH)
/I2C1_SCL: J14.2, R47.2; also elsewhere on the board
/I2C1_SDA: J14.3, R46.2; also elsewhere on the board
/UART2_CTS: J12.4; also elsewhere on the board
/UART2_RTS: J12.5; also elsewhere on the board
/UART2_RX: J12.3, R44.2; also elsewhere on the board
/UART2_TX: J12.2; also elsewhere on the board
/UART3_CTS: J13.4; also elsewhere on the board
/UART3_RTS: J13.5; also elsewhere on the board
/UART3_RX: J13.3, R45.2; also elsewhere on the board
/UART3_TX: J13.2; also elsewhere on the board

Notes on the sheet:
CAN2
GH 1.25mm 4P CAN2_STBY : PC5 CAN2_RX : PB6 CAN2_TX : PB12
GH 1.25mm 4P CAN1_STBY : PC4 CAN1_RX : PD0 CAN1_TX : PD1
TELE1
CAN1
GH 1.25mm 6P PD5 : UART2_TX PD6 : UART2_RX PD3 : UART2_CTS PD4 : UART2_RTS
GH 1.25mm 6P PD8 : UART3_TX PD9 : UART3_RX PD11 : UART3_CTS PD12 : UART3_RTS
I2C
GH 1.25mm 4P I2C_SCL : PB8 : I2C1_SCL I2C_SCL : PB9 : I2C1_SDA
TELE2
