INHA-NARAE/STM32-FC/HW/STM32-FC/STM32-FC.kicad_pcb

## KiCad design HW/STM32-FC/STM32-FC.kicad_pcb (continued)

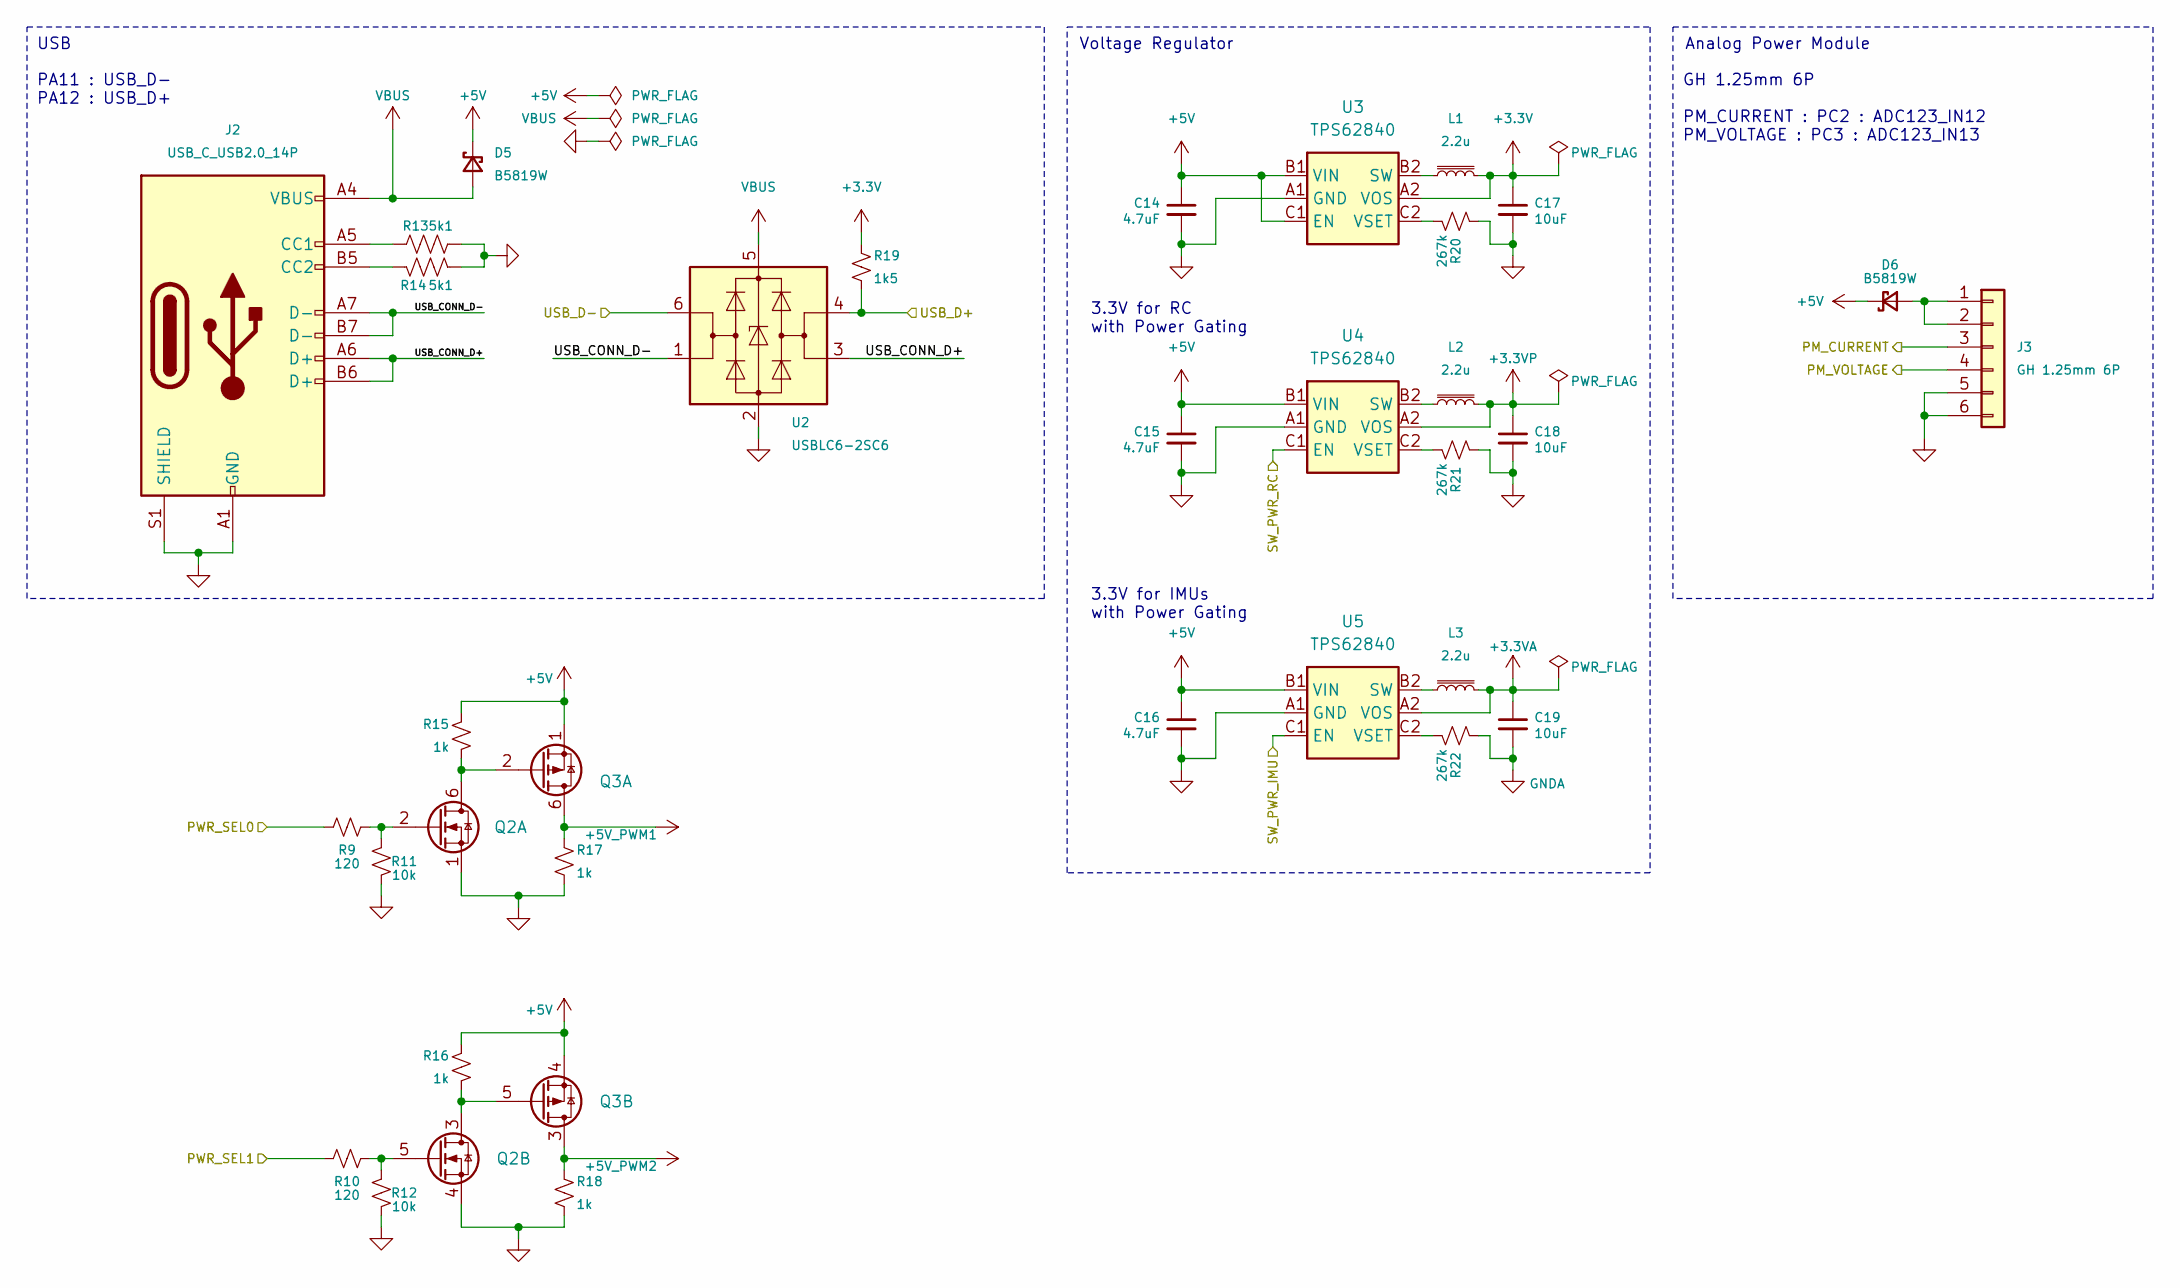
[picture p7: schematic usb.kicad_sch, USB & POWER]

Parts:
C14, C15, C16: 4.7uF; C_0402_1005Metric; LCSC C307423
C17, C18, C19: 10uF; C_0402_1005Metric; LCSC C307415
D5, D6: B5819W; D_SOD-323; LCSC C22624
J2: USB_C_USB2.0_14P; USB_C_Receptacle_GCT_USB4110; LCSC C709031
J3: GH 1.25mm 6P; JST_GH_SM06B-GHS-TB_06x1.25mm_Angled; LCSC C133065
L1, L2, L3: 2.2u; VLS201610ET-2R2M; LCSC C114768
Q2: PMDPB30XN; Nexperia_SOT1118; LCSC C478009
Q3: PMDPB55XP; Nexperia_SOT1118; LCSC C552752
R9, R10: 120; R_0402_1005Metric; LCSC C25079
R11, R12: 10k; R_0402_1005Metric; LCSC C25531
R13, R14: 5k1; R_0402_1005Metric; LCSC C25905
R15, R16, R17, R18: 1k; R_0402_1005Metric; LCSC C106235
R19: 1k5; R_0402_1005Metric; LCSC C25867
R20, R21, R22: 267k; R_0402_1005Metric; LCSC C2998050
U2: USBLC6-2SC6; SOT-23-6; LCSC C7519
U3, U4, U5: TPS62840; Texas_DSBGA-6_0.855x1.255mm_Layout2x3_P0.4mm_LevelC; LCSC C2071139

Connections:
+3.3V: C17.1, L1.2, R19.1, U3.A2 (VOS); also elsewhere on the board
+3.3VA: C19.1, L3.2, U5.A2 (VOS); also elsewhere on the board
+3.3VP: C18.1, L2.2, U4.A2 (VOS); also elsewhere on the board
+5V: C14.1, C15.1, C16.1, D5.1 (K), D6.1 (K), Q3.1 (S), Q3.4 (S), R15.1, R16.1, U3.B1 (VIN), U3.C1 (EN), U4.B1 (VIN), U5.B1 (VIN); also elsewhere on the board
+5V_PWM1: Q3.6 (D), Q3.7 (D), R17.1; also elsewhere on the board
+5V_PWM2: Q3.3 (D), Q3.8 (D), R18.1; also elsewhere on the board
/PM_CURRENT: J3.3; also elsewhere on the board
/PM_VOLTAGE: J3.4; also elsewhere on the board
/PWR_SEL0: R9.1; also elsewhere on the board
/PWR_SEL1: R10.1; also elsewhere on the board
/SW_PWR_IMU: U5.C1 (EN); also elsewhere on the board
/SW_PWR_RC: U4.C1 (EN); also elsewhere on the board
/USB & POWER/USB_CONN_D+: J2.A6 (D+), J2.B6 (D+), U2.3 (I/O2)
/USB & POWER/USB_CONN_D-: J2.A7 (D-), J2.B7 (D-), U2.1 (I/O1)
/USB_D+: R19.2, U2.4 (I/O2); also elsewhere on the board
/USB_D-: U2.6 (I/O1); also elsewhere on the board
unnamed: D6.2 (A), J3.1, J3.2
unnamed: J2.A5 (CC1), R13.1
unnamed: J2.B5 (CC2), R14.1
unnamed: Q2.2 (G), R9.2, R11.1
unnamed: Q2.5 (G), R10.2, R12.1
unnamed: Q2.6 (D), Q2.7 (D), Q3.2 (G), R15.2
unnamed: Q2.3 (D), Q2.8 (D), Q3.5 (G), R16.2
unnamed: L1.1, U3.B2 (SW)
unnamed: R20.2, U3.C2 (VSET)
unnamed: L2.1, U4.B2 (SW)
unnamed: R21.2, U4.C2 (VSET)
unnamed: L3.1, U5.B2 (SW)
unnamed: R22.2, U5.C2 (VSET)
VBUS: D5.2 (A), J2.A4 (VBUS), J2.A9 (VBUS), J2.B4 (VBUS), J2.B9 (VBUS), U2.5 (VBUS)

Notes on the sheet:
Analog Power Module
GH 1.25mm 6P PM_CURRENT : PC2 : ADC123_IN12 PM_VOLTAGE : PC3 : ADC123_IN13
Voltage Regulator
3.3V for IMUs with Power Gating
USB
3.3V for RC with Power Gating
PA11 : USB_D- PA12 : USB_D+

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
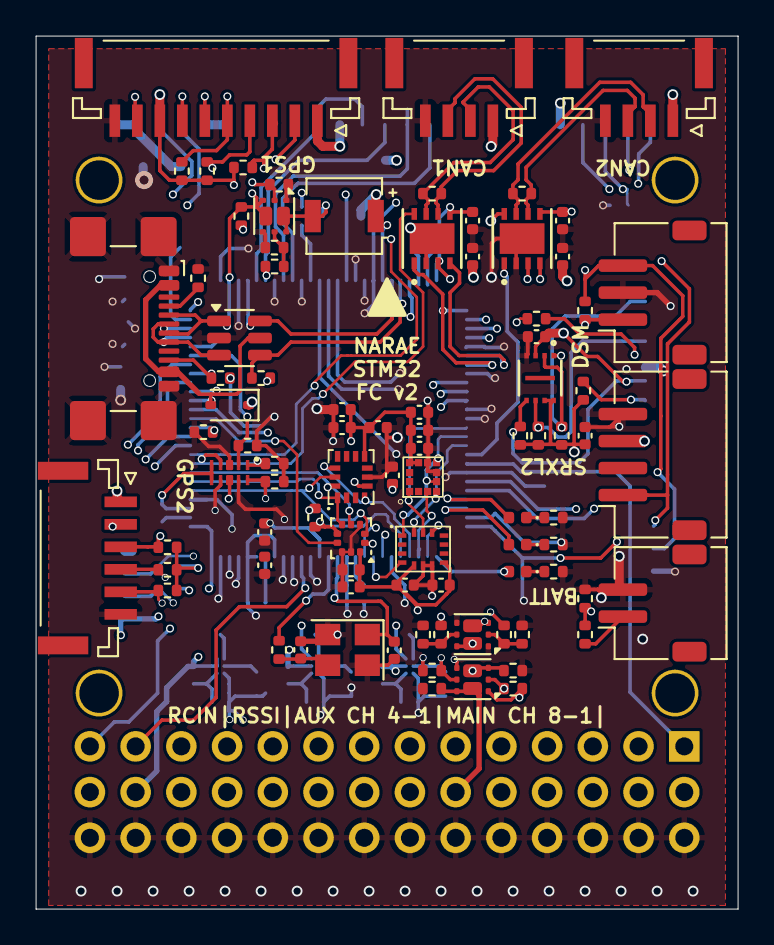
[picture p8: board STM32-FC.kicad_pcb from above]

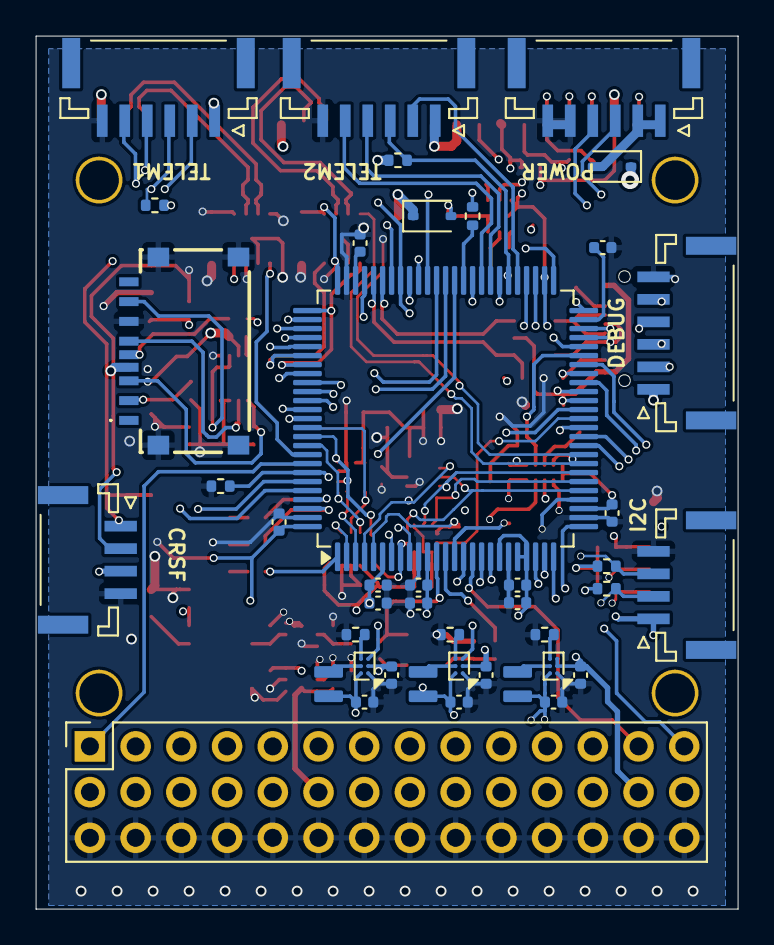
[picture p9: board STM32-FC.kicad_pcb from below]

Board: 4 copper layers, 39.0 x 48.5 mm, 133 parts (42 on the bottom side), 125 nets.
