INHA-NARAE/STM32-FC/SW/Plane/Core/Src/main.c

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
/* Includes ------------------------------------------------------------------*/
#include "main.h"
#include "usb_device.h"

/* USER CODE BEGIN Includes */
#include "usbd_cdc_if.h"

#include <FC_Param/Param.h>
#include <GCS_MAVLink/GCS_MAVLink.h>

#include <FC_Basic/Buzzer/driver.h>

#include <FC_Servo/driver.h>
#include <FC_RC/driver.h>

#include <FC_AHRS/FC_IMU/driver.h>
#include <FC_AHRS/FC_Baro/driver.h>

#include <FC_Log/Log.h>


/* USER CODE END Includes */

/* USER CODE BEGIN PTD */
int _write(int file, char *p, int len)
{
#define PRINT_CDC 1
#if PRINT_CDC == 0
	for(int i=0; i<len; i++)
	{
		while(!LL_USART_IsActiveFlag_TXE(USART2));
		LL_USART_TransmitData8(USART2, *(p+i));
	}
#else
	while(USBD_BUSY == CDC_Transmit_FS((uint8_t*)p, len)) {}
	return len;
#endif
}

/* USER CODE END PTD */


/* USER CODE BEGIN PV */
// Telm1
extern uint8_t uart2_rx_flag;
extern uint8_t uart2_rx_data;

// Telm2
extern uint8_t uart3_rx_flag;
extern uint8_t uart3_rx_data;
/* USER CODE END PV */

void SystemClock_Config(void);
static void MX_GPIO_Init(void);
static void MX_USART1_UART_Init(void);
static void MX_TIM1_Init(void);
static void MX_TIM3_Init(void);
static void MX_TIM4_Init(void);
static void MX_TIM5_Init(void);
static void MX_TIM13_Init(void);
static void MX_TIM14_Init(void);
static void MX_SPI1_Init(void);
static void MX_USART2_UART_Init(void);
static void MX_USART3_UART_Init(void);
static void MX_UART4_Init(void);
static void MX_UART5_Init(void);
static void MX_ADC1_Init(void);
/* USER CODE BEGIN PFP */
extern int PARM_load(void);
/* USER CODE END PFP */

/**
  * @brief  The application entry point.
  * @retval int
  */
int main(void)
{

  /* MCU Configuration--------------------------------------------------------*/

  /* Reset of all peripherals, Initializes the Flash interface and the Systick. */
  HAL_Init();

  /* Configure the system clock */
  SystemClock_Config();

  /* Initialize all configured peripherals */
  MX_GPIO_Init();
  MX_USART1_UART_Init();
  MX_TIM1_Init();
  MX_TIM3_Init();
  MX_TIM4_Init();
  MX_TIM5_Init();
  MX_TIM13_Init();
  MX_TIM14_Init();
  MX_SPI1_Init();
  MX_USART2_UART_Init();
  MX_USART3_UART_Init();
  MX_UART4_Init();
  MX_UART5_Init();
  MX_USB_DEVICE_Init();
  MX_ADC1_Init();
  /* USER CODE BEGIN 2 */

  LL_TIM_EnableCounter(TIM4);
  LL_TIM_EnableCounter(TIM13);
  LL_TIM_EnableCounter(TIM14);

  PARM_load();

  BuzzerPlayInit();

  // interrupt when finished receiving
  LL_USART_EnableIT_RXNE(USART1);
  LL_USART_EnableIT_RXNE(USART2);
  LL_USART_EnableIT_RXNE(USART3);

  // 필수 기기 점검
  SERVO_Initialization();
  RC_Initialization();
  IMU_Initialization();
//  Baro_Initialization();
  BuzzerPlayOneCycle();
  SERVO_doArm();

  /* USER CODE END 2 */

  /* Infinite loop */
  /* USER CODE BEGIN WHILE */
  while (1)
  {
	  RC_GetData();

	  IMU_GetData();
//	  Baro_GetData();

	  if(fsFlag == 1){
		  FS_mannualMode();
	  }
	  else{
		  LL_GPIO_ResetOutputPin(LED_RED_GPIO_Port, LED_RED_Pin);
		  SERVO_control();
	  }

	  Log_Send();

    /* USER CODE END WHILE */

    /* USER CODE BEGIN 3 */
  }
  /* USER CODE END 3 */
}

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
