INHA-NARAE/STM32-FC/SW/Plane/Core/Src/FC_AHRS/FC_Baro/Baro.c

/*
 * Baro.c
 *
 *  Created on: June 7, 2025
 *      Author: leecurrent04
 *      Email : leecurrent04@inha.edu
 */


/* Includes ------------------------------------------------------------------*/
#include <FC_AHRS/FC_Baro/Baro.h>
#include <GCS_MAVLink/GCS_MAVLink.h>


/* Functions -----------------------------------------------------------------*/
/*
 * @brief Baro 초기화
 * @detail Baro 1 - LPS22H
 * @parm none
 * @retval 0
 */
int Baro_Initialization(void)
{
	LL_GPIO_SetOutputPin(LED_RED_GPIO_Port, LED_RED_Pin);
	LL_GPIO_SetOutputPin(LED_YELLOW_GPIO_Port, LED_YELLOW_Pin);

	LPS22HH_Initialization();

	LL_GPIO_ResetOutputPin(LED_RED_GPIO_Port, LED_RED_Pin);
	LL_GPIO_ResetOutputPin(LED_YELLOW_GPIO_Port, LED_YELLOW_Pin);
	return 0;
}


/*
 * @brief 데이터 로딩
 * @detail SCALED_PRESSURE 에 저장
 * @parm none
 * @retval none
 */
unsigned int Baro_GetData(void)
{

	// SCALED_PRESSURE
	LPS22HH_GetData();

	// SCALED_PRESSURE2

//	ComplementaryFilter();
//	KalmanFilter();

	return 0;
}


/* Functions 2 ---------------------------------------------------------------*/
/*
 * @brief 압력을 고도 정보로 변환
 * @detail SCALED_PRESSURE 에 저장
 * @parm float pressure : 현재 고도 (hPa)
 * @parm float temperature : 현재 온도 (cdegC)
 * @retval none
 */
float pascal2meter(float pressure, float temperature)
{
	return (1.0f - powf((pressure / 1013.25f), 0.1902226f)) * (temperature + 273.15f) / 0.0065f;
}
