INHA-NARAE/STM32-FC/(commit log)

2025-06-19 LPS22HH Circuit update
    [NMOS.kicad_sch, NMOS_powerSelector.kicad_sch, PMOS.kicad_sch, PMOS_powerGating.kicad_sch, PMOS_powerGating2.kicad_sch, PMOS_powerSelector.kicad_sch, RC_INPUT.kicad_sch, STM32-FC.kicad_pcb]
2025-06-19 HW Lib and RC code refactoring, GCS_log united and BMI323 IMU init.
    [NMOS.kicad_sch, NMOS_powerSelector.kicad_sch, PMOS.kicad_sch, PMOS_powerGating.kicad_sch, PMOS_powerGating2.kicad_sch, PMOS_powerSelector.kicad_sch, RC_INPUT.kicad_sch, STM32-FC.kicad_sch]
