INHA-NARAE/STM32-FC/(notices)

Notices in the files:
SW/Plane/Core/Src/main.c:
Copyright (c) 2025 STMicroelectronics.
All rights reserved.
This software is licensed under terms that can be found in the LICENSE file
